marcass/tank_lora/kicad/tank_lora.kicad_pcb

## KiCad design kicad/tank_lora.kicad_pcb (2017-08-26)

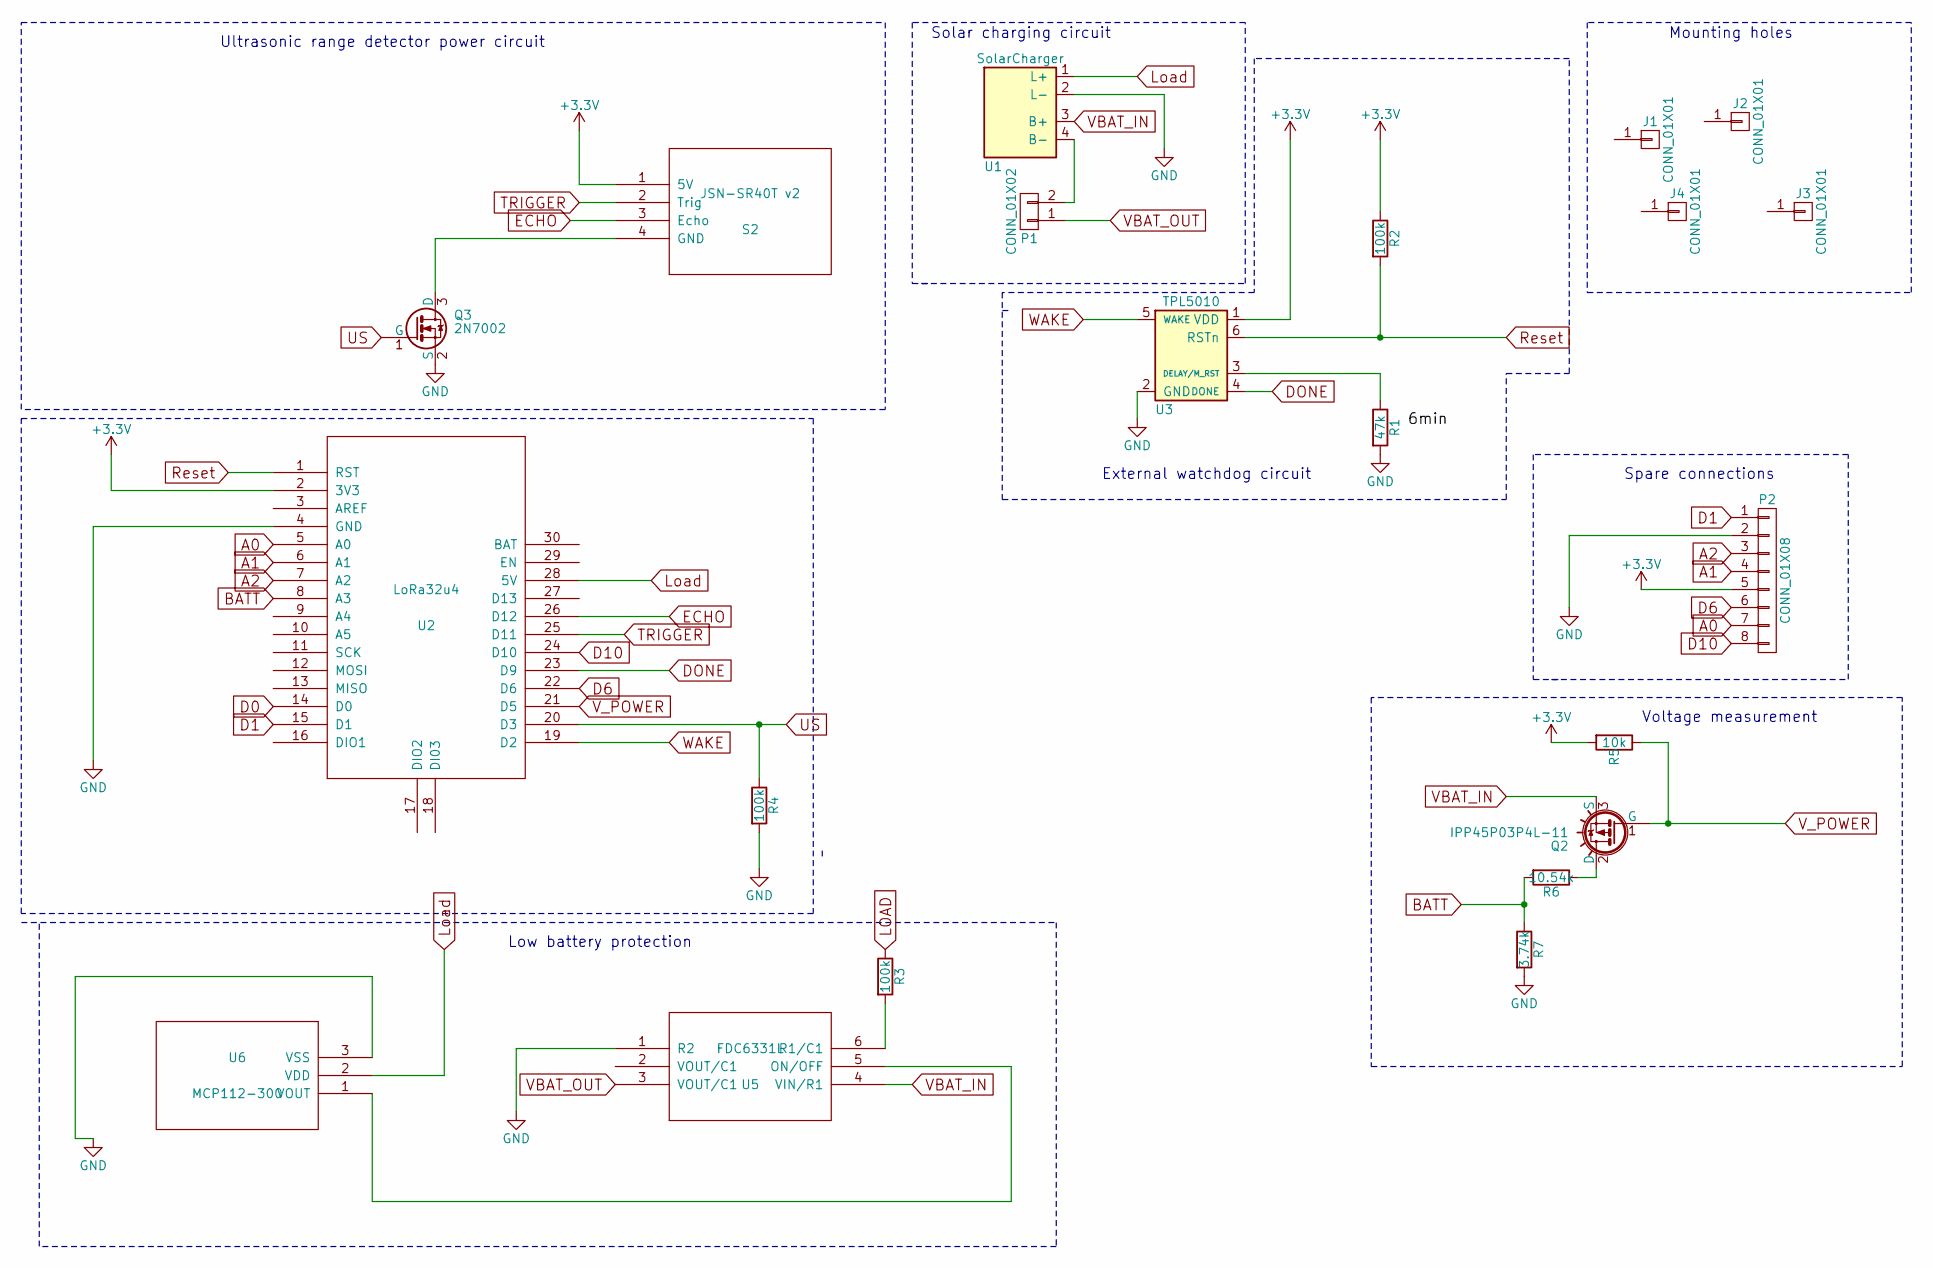
[picture p1: schematic tank_lora.sch]

Parts:
J1, J2, J3, J4: CONN_01X01; MountingHole_3.2mm_M3_DIN965_Pad
P1: CONN_01X02; JST_PH_B2B-PH-K_02x2.00mm_Straight
P2: CONN_01X08; PhoenixContact_MCV-G_08x5.08mm_Vertical
Q2: IPP45P03P4L-11; TO-220_Neutral123_Vertical
Q3: 2N7002; TSOT-23
R1: 47k; Resistor_SMD+THTuniversal_0805to1206_RM10_HandSoldering
R2, R3, R4: 100k; Resistor_SMD+THTuniversal_0805to1206_RM10_HandSoldering
R5: 10k; Resistor_SMD+THTuniversal_0805to1206_RM10_HandSoldering
R6: 10.54k; Resistor_SMD+THTuniversal_0805to1206_RM10_HandSoldering
R7: 3.74k; Resistor_SMD+THTuniversal_0805to1206_RM10_HandSoldering
S2: JSN-SR40T v2; JSN-SR04T
U1: SolarCharger; Solar_charger
U2: LoRa32u4
U3: TPL5010; SOT-23-6_Handsoldering
U5: FDC6331L; TSOT-6-MK06A_Handsoldering
U6: MCP112-300; TO-92_Inline_Wide

Connections:
+3V3: P2.5, R2.1, R5.2, S2.1 (5V), U2.2 (3V3), U3.1 (VDD)
A0: P2.7, U2.5 (A0)
A1: P2.4, U2.6 (A1)
A2: P2.3, U2.7 (A2)
BATT: R6.2, R7.1, U2.8 (A3)
D0: U2.14 (D0)
D1: P2.1, U2.15 (D1)
D6: P2.6, U2.22 (D6)
D10: P2.8, U2.24 (D10)
DONE: U2.23 (D9), U3.4 (DONE)
ECHO: S2.3 (Echo), U2.26 (D12)
GND: P2.2, Q3.2 (S), R1.2, R4.2, R7.2, U1.2 (L-), U2.4 (GND), U3.2 (GND), U5.1 (R2), U6.3 (VSS)
LOAD: R3.1, U1.1 (L+), U2.28 (5V), U6.2 (VDD)
unnamed: P1.2, U1.4 (B-)
unnamed: Q2.2 (D), R6.1
unnamed: Q3.3 (D), S2.4 (GND)
unnamed: R1.1, U3.3 (DELAY/M_RST)
unnamed: R3.2, U5.6 (R1/C1)
unnamed: U5.5 (ON/OFF), U6.1 (VOUT)
Reset: R2.2, U2.1 (RST), U3.6 (RSTn)
TRIGGER: S2.2 (Trig), U2.25 (D11)
US: Q3.1 (G), R4.1, U2.20 (D3)
VBAT_IN: Q2.3 (S), U1.3 (B+), U5.4 (VIN/R1)
VBAT_OUT: P1.1, U5.3 (VOUT/C1)
V_POWER: Q2.1 (G), R5.1, U2.21 (D5)
WAKE: U2.19 (D2), U3.5 (WAKE)

Notes on the sheet:
Voltage measurement
Low battery protection
External watchdog circuit
Solar charging circuit
Ultrasonic range detector power circuit
Mounting holes
Spare connections

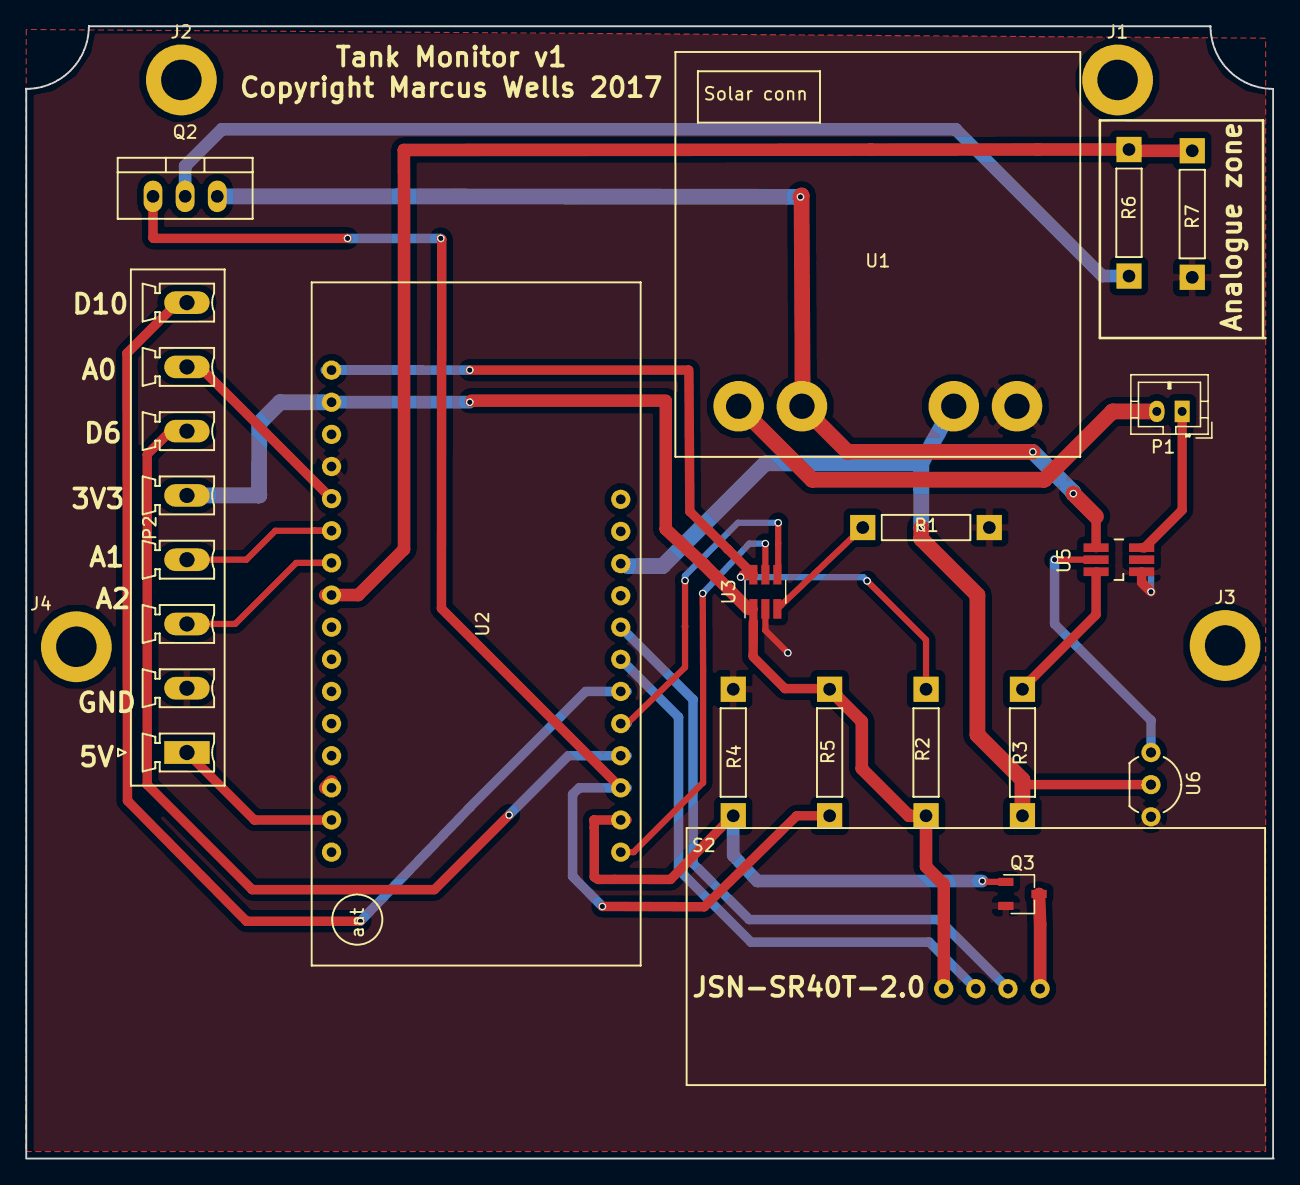
[picture p2: board tank_lora.kicad_pcb from above]

Board: 2 copper layers, 98.6 x 89.5 mm, 21 parts (0 on the bottom side), 25 nets.
