marcass/tank_lora/python/monitor.py

import matplotlib
matplotlib.use('Agg')
import tanks
import pytz
import sys
import time
from threading import Timer
import telepot
import telepot.helper
from telepot.loop import MessageLoop
from telepot.namedtuple import InlineKeyboardMarkup, InlineKeyboardButton
from telepot.delegate import (
    per_chat_id, create_open, pave_event_space, include_callback_query_chat_id)
import telepot.api
import matplotlib.pyplot as plt
#from matplotlib.dates import DayLocator, HourLocator, DateFormatter, drange
import matplotlib.dates as md
matplotlib.rcParams['timezone'] = tanks.tz
from multiprocessing import Queue as Q
from multiprocessing import Process as P
import time
import sys
import serial
import creds
import sql
import numpy as np

#global variables
build_list = []
dur = None
sql_span = None
vers = None
s_port = '/dev/LORA'
#initialise global port
port = None

########### Alert stuff ########################
#fix for protocol error message ( see https://github.com/nickoala/telepot/issues/242 )
def always_use_new(req, **user_kw):
    return None

telepot.api._which_pool = always_use_new

class Keyboard:
    def __init__(self, version):
        #disp = single alert, multi alert, graph request, help etc
        self.version = version

    def format_keys(self, key_tank=0):
        if self.version == 'status':
            if type(key_tank) is list:
                key_list = [InlineKeyboardButton(text='Reset all', callback_data='all reset')]
                for x in key_tank:
                            key_list.append(InlineKeyboardButton(text=x.name +' reset', callback_data=x.name+' reset alert'))
                            #key_list.append(InlineKeyboardButton(text='Get ' +x.name +' graph', callback_data=x.name+' fetch graph'))
                #the following makes a vertical column of buttons (array of array of InlineKeyboardButton's)
                keyboard = InlineKeyboardMarkup(inline_keyboard=[[c] for c in key_list])
                #the following makes a row of buttons (hard to read when lots of alerts)
                #keyboard = InlineKeyboardMarkup(inline_keyboard=[key_list])
            else:
                if key_tank.statusFlag == 'bad':
                    keyboard = InlineKeyboardMarkup(inline_keyboard=[[
                        InlineKeyboardButton(text=key_tank.name+' reset', callback_data=key_tank.name+' reset alert'),
                            InlineKeyboardButton(text='Get ' +key_tank.name +' graph', callback_data=key_tank.name+' fetch graph'),
                            ]])
                else:
                   keyboard = InlineKeyboardMarkup(inline_keyboard=[[
                            InlineKeyboardButton(text='Get ' +key_tank.name +' graph', callback_data=key_tank.name+' fetch graph'),
                             ]])
        elif self.version == 'battstatus':
            key_list = [InlineKeyboardButton(text='Reset all', callback_data='batt reset')]
            for x in key_tank:
                        key_list.append(InlineKeyboardButton(text=x.name +' reset', callback_data=x.name+' reset batt'))
                        #key_list.append(InlineKeyboardButton(text='Get ' +x.name +' graph', callback_data=x.name+' fetch graph'))
            #the following makes a vertical column of buttons (array of array of InlineKeyboardButton's)
            keyboard = InlineKeyboardMarkup(inline_keyboard=[[c] for c in key_list])
        elif self.version == 'helpMe':
            keyboard = InlineKeyboardMarkup(inline_keyboard=[[
                        InlineKeyboardButton(text='Status', callback_data='status'),
                        ]])
        elif self.version == 'alert':
            keyboard = InlineKeyboardMarkup(inline_keyboard=[[
                        InlineKeyboardButton(text=key_tank.name+' reset', callback_data=key_tank.name +' reset alert'),
                        ]])
        elif self.version == 'graphs':
            keyboard = InlineKeyboardMarkup(inline_keyboard=[[
                        InlineKeyboardButton(text='1 day', callback_data='1'),
                        InlineKeyboardButton(text='3 days', callback_data='3'),
                        InlineKeyboardButton(text='7 days', callback_data='7'),
                        ]])

        elif self.version == 'plot':
            keyb_list = []
            for x in key_tank:
                keyb_list.append(InlineKeyboardButton(text=x.name+' ', callback_data=x.name+' add tank'))
            keyboard = InlineKeyboardMarkup(inline_keyboard=[[
                        InlineKeyboardButton(text='Plot tank volume', callback_data='volume'),
                        InlineKeyboardButton(text='Plot battery voltage', callback_data='voltage'),
                        ],[
                           InlineKeyboardButton(text='Days', callback_data='days'),
                           InlineKeyboardButton(text='Hours', callback_data='hours'),
                           ],
                               keyb_list,
                               [InlineKeyboardButton(text='Build', callback_data='add tank build')]
                            ])

        else:
            keyboard = InlineKeyboardMarkup(inline_keyboard=[[
                        InlineKeyboardButton(text='Help', callback_data='help'),
                        InlineKeyboardButton(text='Status', callback_data='status'),
                        ]])
        return keyboard

h = Keyboard('helpMe')
st = Keyboard('status')
a = Keyboard('alert')
g = Keyboard('graphs')
d = Keyboard('plot')
battst = Keyboard('battstatus')

def clean_data(data):
    #std deviation for range is
    a = np.array(data, dtype=np.float32)
    #print data
    #print a.dtype
    b = np.nanstd(a)
    print b
    members = len(data)
    for i in range(members):
        if i < 5:
            c = np.array(data[i:i+10])
        elif i > (members - 5):
            c = np.array(data[i-10:i])
        else:
            c = np.array(data[i-5:i+5], dtype=np.float32)
            #print c
        try:
            d = np.nanmean(c)
            #print d
            if data[i] != None:
                if ((abs(data[i] - d)) > (b/4)):
                    data[i] = None
        except:
            pass
    return data

def median_data(data):
     members = len(data)
     res = data
     for i in range(members):
         start = i
         stop = i+5
         a = data[start:stop]
         try:
             med = np.nanmedian(a)
             res[i] = med
         except:
             pass
     return res


def plot_tank(key_tank, period, target_id, q_range):
    global vers
    global dur
    print vers
    #print 'vers = '+vers
    format_date = md.DateFormatter('%H:%M\n%d-%m')
    # Note that using plt.subplots below is equivalent to using
    # fig = plt.figure and then ax = fig.add_subplot(111)
    fig, ax = plt.subplots()
    if vers == 'water':
        data = 'water_volume'
        label = 'Volume (%)'
    if vers == 'batt':
        data = 'voltage'
        label = 'Battery Voltage'
    if type(key_tank) is list:
        title_name = ''
        print 'building a list of tanks'
        for x in key_tank:
            print x.name +' tank in list'
        for i in key_tank:
            try:
                d = sql.query_via_tankid(i.nodeID, period, q_range)
                medians = median_data(d[data])
                ax.plot_date(d['timestamp'],medians, i.line_colour, label=i.name)
                title_name += ' '+i.name
                ax.set(xlabel='Datetime', ylabel=label, title='Tanks '+label)
            except:
                message = bot.sendMessage(target_id, "Please resend the plot request, eg '/plot 1' as there has been a problem")
                #pass
            #ax.plot_date(d['timestamp'],d[data], i.line_colour, label=i.name, marker='o', markersize='5')
        title_name += ' plot'
    else:
        d = sql.query_via_tankid(key_tank.nodeID, period, q_range)
        if vers == 'bi_plot':
            print 'bi_plot found'
            title_name = 'Water Level and Voltage for '+key_tank.name+' Tank'
	    ax.plot_date(d['timestamp'],d['water_volume'], 'b', label='Water Volume (l)')
            #ax.plot_date(d['timestamp'],d['water_volume'], 'b', label='Water Volume (l)',  marker='o', markersize='5')
            ax.set_xlabel('Time')
            # Make the y-axis label, ticks and tick labels match the line color.
            ax.set_ylabel('Water Volume', color='b')
            ax.tick_params('y', colors='b')
            ax2 = ax.twinx()
            ax2.plot_date(d['timestamp'],d['voltage'], 'r', label='Voltage (V)', marker='p', markersize='5')
            ax2.set_ylabel('Voltage', color='r')
            ax2.tick_params('y', colors='r')
        else:
            print 'kncoking on through'
            title_name = key_tank.name+' plot'
            ax.plot_date(d['timestamp'],d[data], key_tank.line_colour, label=key_tank.name, marker='o', markersize='5')
            ax.set(xlabel='Datetime', ylabel=label, title=key_tank.name+' '+label)
    if vers == 'water':
        plt.axhspan(10, 100, facecolor='#2ca02c', alpha=0.3)
    if vers == 'batt':
        plt.axhspan(3.2, 4.2, facecolor='#2ca02c', alpha=0.3)
    ax.get_xaxis().set_major_formatter(format_date)
    #times = ax.get_xticklabels()
    #plt.setp(times, rotation=30)
    plt.legend()
    ax.grid()
    plt.tight_layout()
    fig.savefig(tanks.tank_list[0].pngpath+'net.png')
    plt.close()
    #send_graph = bot.sendPhoto(target_id, open(tanks.tank_list[0].pngpath +'net.png'), title_name)
    send_graph = bot.sendPhoto(target_id, open(tanks.tank_list[0].pngpath +'net.png'))


def on_chat_message(msg):
    global dur
    global vers
    content_type, chat_type, chat_id = telepot.glance(msg)
    try:
        text = msg['text']
	tank_names = [i.name for i in tanks.tank_list]
        help_text = "This bot will alert you to low water levels in the farm tanks. Any message you send will be replied to by the bot. If it is not formatted correctly you will get this message again. Sending the following will give you a result:\n'/status' to get the status of all tanks  (or click the status button)\n'/status [tank name]' to get individual tank status with the option to graph them. Valid names are: "+str(tank_names)+" \n'/plot [number of days/hours]' to build a graph with custom tank volumes in it over [days/hours] \n'/special stuff' to get other functions"
        if ('/help' in text) or ('/Help' in text) or ('/start' in text):
            message = bot.sendMessage(chat_id, help_text, reply_markup=h.format_keys())
        elif ('/status' in text) or ('/Status' in text):
            #hasKey = lambda text, tanks.tanks_by_name: any(k in text for k in tanks.tanks_by_name)
            if any(k in text for k in tanks.tanks_by_name):
                in_tank = tanks.tanks_by_name[text.split(' ')[-1]]
                status_mess(in_tank, chat_id)
            else:
                status_mess('all', chat_id)
        elif ('/Plot' in text) or ('/plot' in text):# or ('/batt' in text):
            #reset variables
            dur = None
            sql_span = None
            vers = None
            in_msg = text.split(' ')
            msg_error = 0
            if len(in_msg) == 2:
	        dur = in_msg[1]
                if dur.isdigit():
                    #message = bot.sendMessage(chat_id, 'Blay, blah', reply_markup=d.format_keys(tanks.tank_list))
                    message = bot.sendMessage(chat_id, "Please select the button(s) that apply in each row of buttons, then click the 'Build' button to produce the graph", reply_markup=d.format_keys(tanks.tank_list))
                    #message = bot.sendMessage(chat_id, 'Click the button for each tank you would like then click the build button when done', reply_markup=b.format_keys(tanks.tank_list, vers))
                else:
                    msg_error = 1
            else:
                msg_error = 1
            if msg_error:
                message = bot.sendMessage(chat_id, "I'm sorry, I can't recognise that. Please type '/plot [number]', eg /plot 2")
        elif '/special stuff' in text:
            message = bot.sendMessage(chat_id, '"/vl [days] [tank]" will plot voltage data and volume data for the specified tank, eg /vl 1 top\n"/battstatus" will give battery status')
        elif '/vl' in text:
            in_msg = text.split(' ')
            volt_error = 0
            print in_msg
            if len(in_msg) == 3:
                if any(k in text for k in tanks.tanks_by_name):
                    in_tank = tanks.tanks_by_name[text.split(' ')[2]]
                    print 'in_tank = '+in_tank.name
                    days = text.split(' ')[1]
                    print days
                    if days.isdigit():
                        vers = 'bi_plot'
                        print 'version b4 plot '+vers
                        plot_tank(in_tank, days, chat_id, 'days')
                        print 'version afer plot '+vers
                        vers = None
                        return
                    else:
                        volt_error = 1
                else:
                    volt_error = 1
            else:
                volt_error = 1
            if volt_error:
                message = bot.sendMessage(chat_id, "I'm sorry, I can't recognise that. Please type '/vl [days] [tank name]', eg /vl 1 top")
        elif "/battstatus" in text:
            battstatus_mess(chat_id)
        else:
            message = bot.sendMessage(chat_id, "I'm sorry, I don't recongnise that request (=bugger off, that does nothing). " +help_text, reply_markup=h.format_keys())
    except KeyError:
        bot.sendMessage(chat_id, "There's been a cock-up. Please let Marcus know what you just did (if it wasn't adding somebody to the chat group)")

def on_callback_query(msg):
    global dur
    global sql_span
    global build_list
    global vers
    query_id, from_id, query_data = telepot.glance(msg, flavor='callback_query')
    #print('Callback Query:', query_id, from_id, query_data)
    #print msg
    target_id = msg['message']['chat']['id']
    if query_data == 'all reset':
        #print 'resetting all on callback'
        for x in tanks.tank_list:
            x.set_status('OK')
        bot.sendMessage(target_id, "All tank's status now reset to OK", reply_markup=h.format_keys())
        return
    query_tank_name = query_data.split(' ')[0]
    if query_data == 'batt reset':
        for x in tanks.tank_list:
            x.set_battstatus('OK')
        bot.sendMessage(target_id, "All tank's battery status now reset to OK", reply_markup=h.format_keys())
    #print 'query tank name = '+query_tank_name
    if tanks.tanks_by_name.has_key(query_tank_name):
        query_tank = tanks.tanks_by_name[query_tank_name]
        #print 'found a tank called '+query_tank.name
        if 'add tank' in query_data:
            #print 'found "add tank" in query data'
            if (query_tank not in build_list):
                #print 'appending '+query_tank.name
                build_list.append(query_tank)
            else:
                print query_tank.name+' already added'
            return
        if 'reset batt' in query_data:
            query_tank.set_battstatus('OK')
        if 'reset alert' in query_data:
            #print tank.name +' ' +tank.statusFlag
            #print 'resetting all on callback individually'
            query_tank.set_status('OK')
            #print tank.statusFlag
            bot.answerCallbackQuery(query_id, text='Alert now reset')
            bot.sendMessage(target_id, query_tank.name +' reset to ' +query_tank.statusFlag)
            return
        if 'fetch graph' in query_data:
            bot.sendMessage(target_id, query_tank.name +' would like to send you some graphs. Which would you like?', reply_markup=g.format_keys(query_tank))
            return
        elif query_data == 'status':
            status_mess(query_tank, target_id)
            return
    if query_data == 'help':
        bot.sendMessage(target_id, 'Send "/help" for more info', reply_markup=h.format_keys())
        return
    if 'add tank build' in query_data:
        if vers == None:
            bot.sendMessage(target_id, 'Please select a data type to plot (Voltage or Volume) by clicking the approriate button above')
        #print 'period in build = '+str(dur)+' '+sql_span
        plot_tank(build_list, dur, target_id, sql_span)
        #clear variables
        build_list = [] # finished build, so empty list
        return
    if 'hours' in query_data:
        #print 'added ' +query_data +' to options'
        sql_span = 'hours'
        return
    if 'days' in query_data:
        #print 'added ' +query_data +' to options'
        sql_span = 'days'
        return
    if 'voltage' in query_data:
        #print 'added ' +query_data +' to options'
        vers = 'batt'
        return
    if 'volume' in query_data:
        #print 'added ' +query_data +' to options'
        vers = 'water'
        return
    if query_data == 'status':
        status_mess('all', target_id)
        return
    if query_data == '1' or '3' or '7':
        #print query_data
        conv = str(query_data)
        in_tank_name = msg['message']['text'].split(' ')[0]
        #print 'tank is '+in_tank_name
        if tanks.tanks_by_name.has_key(in_tank_name):
            graph_tank = tanks.tanks_by_name[in_tank_name]
            #print 'tank is '+graph_tank.name
            vers = 'water'
            plot_tank(graph_tank, query_data, target_id, 'days')
            vers = None
            return


TOKEN = creds.botAPIKey
botID = creds.bot_ID
bot = telepot.Bot(TOKEN)
MessageLoop(bot, {'chat': on_chat_message, 'callback_query': on_callback_query}).run_as_thread()
print('Listening ...')

#def capacity(tank, payload):
     #percentage = 1/((payload - tank.invalid_min)/(tank.max_payload - tank.invalid_min)) * 100
     #print tank.name +' is at '+str(percentage)+' percentage'
     #return percentage


def sort_data(data):
    global vers
    #while True:
        #while (q.empty() == False):
    #data = q.get()
    try:
        in_node = data[0]
        if tanks.tanks_by_nodeID.has_key(in_node):
            rec_tank = tanks.tanks_by_nodeID[in_node]
            print 'found tank is '+rec_tank.name
            #print 'following in the instance statusFlags:'
            #for y in tanks.tank_list:
                #print 'status for ' +y.name+' is '+y.get_status()
        else:
            print 'tank not found'
            return
        print data
        #print 'Status as seen in sort_data'
        #for x in tanks.tank_list:
            #print x.name +' is ' +x.statusFlag
        dist = data[1]
        batt = data[2]
        try:
            dist = int(dist)
            if (dist < rec_tank.invalid_min) or (dist > rec_tank.max_payload):
                print 'Payload out of range'
                level = None
            else:
                print 'payload in range'
                dist = dist - rec_tank.invalid_min
                level = float(rec_tank.pot_dist - dist)/float(rec_tank.pot_dist) * 100.0
                if level < rec_tank.min_percent:
                    #print rec_tank.name +' under thresh'
                    #print rec_tank.name+' status prechange is '+rec_tank.statusFlag
                    if rec_tank.statusFlag != 'bad':
                        #print 'dropping through and changing status'
                        rec_tank.set_status('bad')
                        #print rec_tank
                        #print 'new status is '+rec_tank.statusFlag
                        vers = 'water'
                        plot_tank(rec_tank, '1', creds.group_ID, 'days')
                        #print 'plotted'
                        send = bot.sendMessage(creds.group_ID, rec_tank.name +' tank is low', reply_markup=a.format_keys(rec_tank))
                        #print 'sent'
                    elif rec_tank.statusFlag == 'bad':
                        print 'ignoring low level as status flag is '+rec_tank.statusFlag
                    else:
                        print 'status flag error'
                else:
                    print 'level fine, doing nothing'
        except:
            print 'exception for some reason'
            level = None
        try:
            batt = float(batt)
            if (batt == 0) or (batt > 5.0):
                batt = None
            elif batt < 3.2:
                if rec_tank.battstatusFlag != 'low':
                    rec_tank.set_battstatus('low')
                    vers = 'batt'
                    plot_tank(rec_tank, '1',creds.marcus_ID, 'days')
                elif rec_tank.battstatusFlag == 'low':
                    print 'ignoring low battery as status flag is '+rec_tank.battstatusFlag
                else:
                    print 'status flag error'

        except:
            batt = None
        #add to db
        print 'writing value voltage ' +str(batt) +' and volume ' +str(level) +' to db for ' +tanks.tanks_by_nodeID[in_node].name
        sql.add_measurement(in_node,level,batt)
    except:
        print 'malformed string'


def status_mess(tag, chat_id):
    #print 'status message follows!:'
    ##for y in tanks.tank_list:
        ##print 'status for ' +y.name+' is '+y.statusFlag
    #for y in tanks.tank_list:
        #print y
        #print 'status for '+y.name+' is  '+y.get_status()
    if tag == 'all':
        data = 'Tank water status:\n'
        bad = []
        for x in tanks.tank_list:
            data = data +x.name +' is ' +x.statusFlag +'\n'
            if x.statusFlag == 'bad':
                bad.append(x)
            #message = bot.sendMessage(creds.group_ID,
            #tank.name+' is '+tank.statusFlag, reply_markup=st.format_keys(tank))
        message = bot.sendMessage(chat_id, data, reply_markup=st.format_keys(bad))
    else:
        message = bot.sendMessage(chat_id, tag.name+' is '+tag.statusFlag, reply_markup=st.format_keys(tag))

def battstatus_mess(chat_id):
    data = 'Tank battery status:\n'
    bad = []
    for x in tanks.tank_list:
        data = data +x.name +' is ' +x.battstatusFlag +'\n'
        if x.battstatusFlag == 'low':
            bad.append(x)
        #message = bot.sendMessage(creds.group_ID,
        #tank.name+' is '+tank.statusFlag, reply_markup=st.format_keys(tank))
    message = bot.sendMessage(chat_id, data, reply_markup=battst.format_keys(bad))

def readlineCR(port):
    try:
        rv = ''
        while True:
            ch = port.read()
            rv += ch
            if ch=='\n':# or ch=='':
                if 'PY' in rv:              #arduino formats message as PY;<nodeID>;<waterlevle;batteryvoltage;>\r\n
                    #print 'Printing status flags stuff on receive'
                    #for x in tanks.tank_list:
                        #print x.name +' is ' +x.statusFlag
                    print rv
                    rec_split = rv.split(';')   #make array like [PYTHON, nodeID, payloadance]
                    print rec_split
                    sort_data(rec_split[1:4])
                    #q.put(rec_split[1:4])           #put data in queue for processing at rate
                    rv = ''
    except (KeyboardInterrupt, SystemExit):
        print "Interrupted"
        sys.exit()
    except:
        print 'failed on port read'
        port_start()

#Serial port function opening fucntion
def port_check(in_port):
    global port
    try:
        port = serial.Serial(in_port, baudrate=9600, timeout=3.0)
        print s_port+' found'
        return port
    except:
        port = None
        return port

def port_start():
    count = 0
    #handle exceptions for absent port (and keep retrying for a while)
    while (port_check(s_port) is None) and (count < 100):
        count = count + 1
        print s_port+' not found '+str(count)+' times'
        time.sleep(10)
        if count == 100:
            print 'Exited because serial port not found'
            sys.exit()
    while True:
        rcv = readlineCR(port)

#setup database
sql.setup_db()

#setup port and start loop
port_start()
