marcass/tank_lora/arduino/tests/duplex_test/duplex_test.ino

/*
  LoRa Duplex communication

  Sends a message every half second, and polls continually
  for new incoming messages. Implements a one-byte addressing scheme,
  with 0xFF as the broadcast address.

  Uses readString() from Stream class to read payload. The Stream class'
  timeout may affect other functuons, like the radio's callback. For an

  created 28 April 2017
  by Tom Igoe
*/
#include <SPI.h>              // include libraries
#include <LoRa.h>

const int csPin = 1;          // LoRa radio chip select
const int resetPin = 4;       // LoRa radio reset
const int irqPin = 7;         // change for your board; must be a hardware interrupt pin

String outgoing;              // outgoing message
bool forwarded;

byte msgCount = 0;            // count of outgoing messages
byte localAddress = 0xBB;     // address of this device
byte destination = 0xFF;      // destination to send to
long lastSendTime = 0;        // last send time
int interval = 2000;          // interval between sends

void setup() {
  Serial.begin(9600);                   // initialize serial
  //while (!Serial);

  Serial.println("LoRa Duplex");

  // override the default CS, reset, and IRQ pins (optional)
  LoRa.setPins(csPin, resetPin, irqPin);// set CS, reset, IRQ pin

  if (!LoRa.begin(433E6)) {
    Serial.println("Starting LoRa failed!");
    while (1);
  }

  Serial.println("LoRa init succeeded.");
}

void loop() {
  if (millis() - lastSendTime > interval) {
    String message = "HeLoRa World from duplex!";   // send a message
    sendMessage(message, localAddress);
    Serial.println("Sending " + message);
    lastSendTime = millis();            // timestamp the message
    interval = random(10000) + 1000;   
  }

  // parse for a packet, and call onReceive with the result:
  onReceive(LoRa.parsePacket());
  //Serial.println("Looping....");
}

void sendMessage(String outgoing) {
  LoRa.beginPacket();                   // start packet
  //LoRa.write(destination);              // add destination address
  //LoRa.write(localAddress);             // add sender address
//  LoRa.write(msgCount);                 // add message ID
//  LoRa.write(outgoing.length());        // add payload length
  LoRa.print(outgoing);                 // add payload
  if(forwarded){
    LoRa.print("Forwarded message");
    forwarded = false;
  }
  LoRa.endPacket();                     // finish packet and send it
  msgCount++;                           // increment message ID
}

void onReceive(int packetSize) {
  if (packetSize == 0) return;          // if there's no packet, return

  // read packet header bytes:
  //int recipient = LoRa.read();          // recipient address
  byte sender = LoRa.read();            // sender address
//  byte incomingMsgId = LoRa.read();     // incoming msg ID
 // byte incomingLength = LoRa.read();    // incoming msg length
  

  String incoming = "";

  while (LoRa.available()) {
    incoming += (char)LoRa.read();
  }
  Serial.print("Incoming message: ");
  Serial.println(incoming);
  Serial.println("sender: " + String(sender));

//  if (incomingLength != incoming.length()) {   // check length for error
//    Serial.println("error: message length does not match length");
//    return;                             // skip rest of function
//  }

  //if the recipient isn't this device or broadcast,
  if (sender != 0xFF) {
    Serial.println("This message is not for me.");
    return;                             // skip rest of function
  }

  // if message is for this device, or broadcast, print details:
  Serial.println("Received from: 0x" + String(sender, HEX));
//  Serial.println("Sent to: 0x" + String(recipient, HEX));
//  Serial.println("Message ID: " + String(incomingMsgId));
//  Serial.println("Message length: " + String(incomingLength));
  Serial.println("Message: " + incoming);
//  Serial.println("RSSI: " + String(LoRa.packetRssi()));
//  Serial.println("Snr: " + String(LoRa.packetSnr()));
  Serial.println("Now forwarding packet");
  forwarded = true;
  sendMessage(incoming);
}
