marcass/tank_lora/arduino/tests/diy_mall_sender/diy_mall_sender.ino

#include <SPI.h>
#include <LoRa.h>

// uncomment the section corresponding to your board
// BSFrance 2017 contact@bsrance.fr 

//  //LoR32u4 433MHz V1.0 (white board)
//  #define SCK     15
//  #define MISO    14
//  #define MOSI    16
//  #define SS      1
//  #define RST     4
//  #define DI0     7
//  #define BAND    433E6 
//  #define PABOOST true

//  //LoR32u4 433MHz V1.2 (white board)
  #define SCK     15
  #define MISO    14
  #define MOSI    16
  #define SS      8
  #define RST     4
  #define DI0     7
  #define BAND    433E6 
  #define PABOOST true 

  //LoR32u4II 868MHz or 915MHz (black board)
//  #define SCK     15
//  #define MISO    14
//  #define MOSI    16
//  #define SS      8
//  #define RST     4
//  #define DI0     7
//  #define BAND    868E6  // 915E6
//  #define PABOOST true 

int counter = 0;

void setup() {
  delay(7000);
  Serial.begin(9600);
  while (!Serial);
  Serial.println("LoRa Sender");
  LoRa.setPins(SS,RST,DI0);
  if (!LoRa.begin(BAND,PABOOST)) {
    Serial.println("Starting LoRa failed!");
    while (1);
  }
}

void loop() {
  Serial.print("Sending packet: ");
  Serial.println(counter);
  // send packet
  LoRa.beginPacket();
  LoRa.print("hello ");
  LoRa.print(counter);
  LoRa.endPacket();
  counter++;
  delay(5000);
}
