marcass/tank_lora/arduino/tests/US_test_forV2/US_test_forV2.ino

#define ECHOPIN 12// Pin to receive echo pulse
#define TRIGPIN 11// Pin to send trigger pulse
#define POWER 3
void setup(){
  Serial.begin(9600);
  pinMode(TRIGPIN, OUTPUT);
  pinMode(POWER, OUTPUT);
  digitalWrite(POWER, HIGH);
  //digitalWrite(POWER, LOW);
  pinMode(ECHOPIN, INPUT_PULLUP);
}
void loop(){
  //power up mosfet
  //digitalWrite(POWER, HIGH);
  //delay for saturation
  //delay(350);
  digitalWrite(TRIGPIN, LOW); // Set the trigger pin to low for 2uS
  delayMicroseconds(2);
  digitalWrite(TRIGPIN, HIGH); // Send a 10uS high to trigger ranging
  delayMicroseconds(10);
  digitalWrite(TRIGPIN, LOW); // Send pin low again
  int distance = pulseIn(ECHOPIN, HIGH,26000); // Read in times pulse
  distance= distance/58;
  Serial.print(distance);
  Serial.println("   cm"); 
  //power down mosfet
  //delay(500);
  //digitalWrite(POWER, LOW);                   
  delay(1000);// Wait 50mS before next ranging
}
