marcass/tank_lora/(commit log)

2017-06-19 kicad initialisation
    [tank_lora.kicad_pcb, tank_lora.sch]
2017-06-20 furhter kicad updates
    [tank_lora.sch]
2017-07-02 started arduino stuff
    [tank_lora.sch]
2017-07-03 code tweaks
    [tank_lora.sch]
2017-07-03 reverse engineered NSS RST pin connection to get radio working
2017-07-03 updated pin mapping in sketch and docs, not recieving
2017-07-04 added lib for LoRa32u4
    [tank_lora.sch]
2017-07-04 more power stuff
2017-07-04 aligned sketch with schematic
    [tank_lora.sch]
2017-07-06 Remove BOD
    [tank_lora.sch]
2017-07-06 update schematic for MOSFET and begin pin setting for sleep in sketch
    [tank_lora.sch]
2017-07-08 added libs, updated schematic
    [tank_lora.sch]
2017-07-09 tidied pcb schematic and updated sketch accordingly
    [tank_lora.sch]
2017-07-09 started pcb layout
    [tank_lora.kicad_pcb, tank_lora.sch]
2017-07-20 separated classes, got callback buttons working (largely)
2017-07-20 fix for callback issue
    [alerts.py]
2017-07-21 rrd prblem when running as systemd process fixed (i think)
    [alerts.py]
2017-07-22 component changes
    [tank_lora.sch]
2017-07-23 get battery graph going
2017-07-23 updated battery alert value
2017-07-24 poss fix for protocol error
    [alerts.py]
2017-07-24 updated schmeatic with mosfet model
    [tank_lora.sch]
2017-07-24 updated some glitches in sketch
    [sensor_node.ino]
2017-07-24 sleep test and current measurement test
2017-07-24 pcb update
    [tank_lora.kicad_pcb, tank_lora.sch]
2017-07-25 sleep tests
    [tank_lora.sch]
2017-07-26 footprint addition and test current for sleeping without adc
2017-07-26 updated pcb with test info
    [tank_lora.kicad_pcb, tank_lora.sch]
2017-07-27 update pcb
    [tank_lora.kicad_pcb, tank_lora.sch]
2017-07-27 the turd continues to be polished
    [tank_lora.kicad_pcb, tank_lora.sch]
2017-07-29 production ready
    [tank_lora.kicad_pcb]
2017-07-29 final order
    [tank_lora.kicad_pcb]
2017-08-03 little problem with new tanks fixed
    [queue_listen.py]
2017-08-03 button formatting
2017-08-03 sorted messasge handling bug
    [alerts.py]
2017-08-07 switching from rrd to matplotlib and sqllite
2017-08-07 sorted v2 sensor
2017-08-10 duplex forwarder/sensor added and polished alerts
2017-08-10 tidying up debug prints
2017-08-10 colour updated and title fixed
    [alerts.py]
2017-08-15 udev rules added and tidied arduino stuff
2017-08-17 no problems wiht pulsein!
    [sensor_node_test.ino]
2017-08-20 updated for error values
    [alerts.py, queue_listen.py]
2017-08-20 arduino polishing
2017-08-20 sketch updated for calibration with internal ref for chip variation
2017-08-20 updated resistor value
    [tank_lora.sch]
2017-08-22 temperature sensing
2017-08-24 fix variable overlap for top in future, otherwise got going for now
    [monitor.py]
2017-08-24 tidying arduino code
2017-08-24 changed timer and node
2017-08-26 updated board remvoing 5V rail
    [tank_lora.kicad_pcb, tank_lora.sch]
2017-08-31 update issues for status
    [monitor.py]
2017-09-02 sorted status persistence and remved battery alert plot
2017-09-02 set readio power on forwarder
2017-09-04 added batt status reset abilities
    [monitor.py]
2017-09-27 filtering progress
2017-09-28 filtered data in group plot
2017-11-19 changed boundary values on batt voltage
2018-05-18 cleaning up for dry run before dummy data insertion
2018-05-20 failing to add junk data to db becuase of niggly exception
    [monitor.py]
2018-05-29 chomod of socket
2018-06-05 problems found, i think
    [monitor.py]
2018-08-30 circular buffer and median filtering
2018-09-01 token problems or threads?
    [monitor.py]
2018-09-01 blocking serial. using threads
2019-02-02 gleaning junk data from arduino in docker container
2019-03-01 getting esp32oled lora on wifi and sending data (failing)
2019-03-04 removed serial prints, tidied up display
2019-08-10 updated link for watchdog timer (not workign at present)
2019-12-28 debugging receivers
    [tanks.csv]
2019-12-28 more data and checked out forwarder script
    [tanks.csv]
2019-12-29 getting http post working
    [tanks.csv]
2019-12-29 cleaning up crazy forwarding
    [tanks.csv]
2019-12-30 changed some pin assignments
    [tanks.csv]
2021-06-30 working config in testing esp32
