marcass/tank_lora/(notices)

Notices in the files:
kicad/tank_lora.kicad_pcb:
Copyright Marcus Wells 2017
